minou65/NMEA2000-SensorBoard/NMEA-Sensorboard.brd

## EAGLE design NMEA-Sensorboard.brd (2026-08-22)

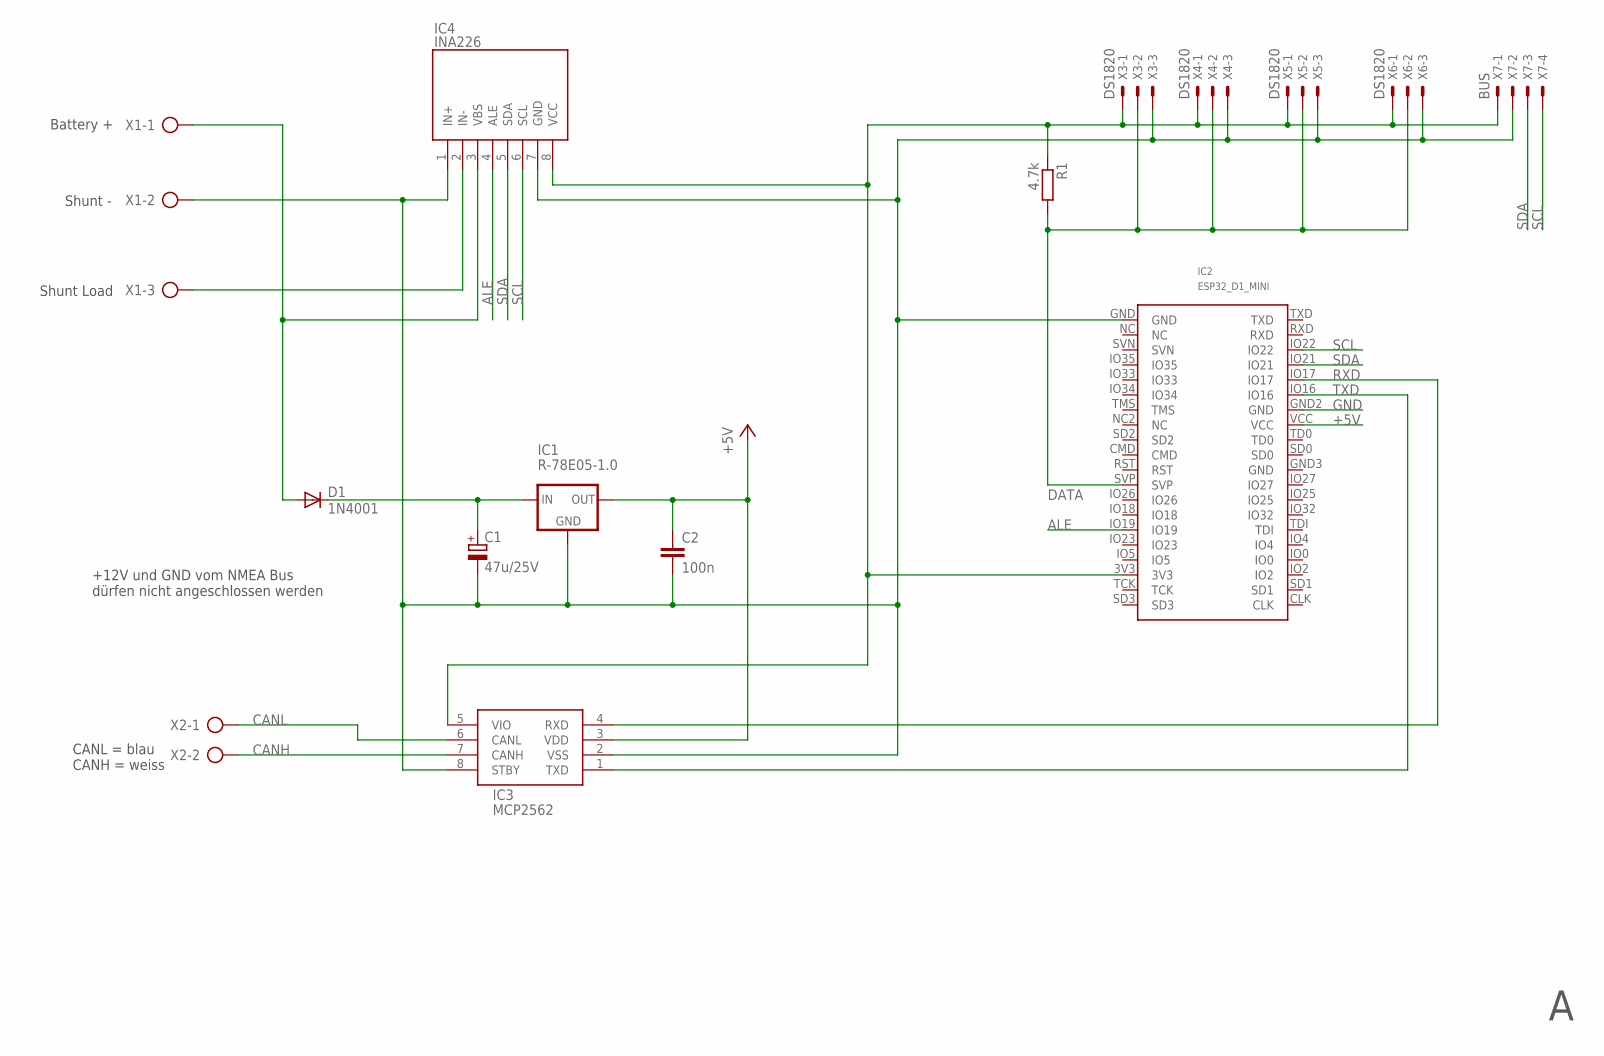
[picture p4: schematic NMEA-Sensorboard.sch]

Parts:
C1: 47u/25V; E2-5
C2: 100n; C050-024X044
D1: 1N4001; SOD80
IC1: R-78E05-1.0; R-78E-XX1.0
IC2: ESP32_D1_MINI
IC3: MCP2562; SO-8
IC4: INA226
R1: 4.7k; R0805
X1: AK500/3
X2: AK500/2
X3, X4, X5, X6: DS1820; 22-23-2031
X7: BUS; 22-23-2041

Connections:
12V: D1.A, IC4.3 (VBS), X1.1
+3V3: IC2.3V3, IC3.5 (VIO), IC4.8 (VCC), R1.1, X3.1, X4.1, X5.1, X6.1, X7.1
+5V: C2.1, IC1.OUT, IC2.VCC, IC3.3 (VDD)
ALE: IC2.IO19, IC4.4 (ALE)
CANH: IC3.7 (CANH), X2.2
CANL: IC3.6 (CANL), X2.1
DATA: IC2.SVP, R1.2, X3.2, X4.2, X5.2, X6.2
GND: C1.-, C2.2, IC1.GND, IC2.GND, IC2.GND2 (GND), IC3.2 (VSS), IC3.8 (STBY), IC4.1 (IN+), IC4.7 (GND), X1.2, X3.3, X4.3, X5.3, X6.3, X7.2
LOAD: IC4.2 (IN-), X1.3
unnamed: C1.+, D1.C, IC1.IN
RXD: IC2.IO17, IC3.4 (RXD)
SCL: IC2.IO22, IC4.6 (SCL), X7.4
SDA: IC2.IO21, IC4.5 (SDA), X7.3
TXD: IC2.IO16, IC3.1 (TXD)

Notes on the sheet:
CANL = blau CANH = weiss
Shunt -
Shunt Load
Battery +
+12V und GND vom NMEA Bus dürfen nicht angeschlossen werden

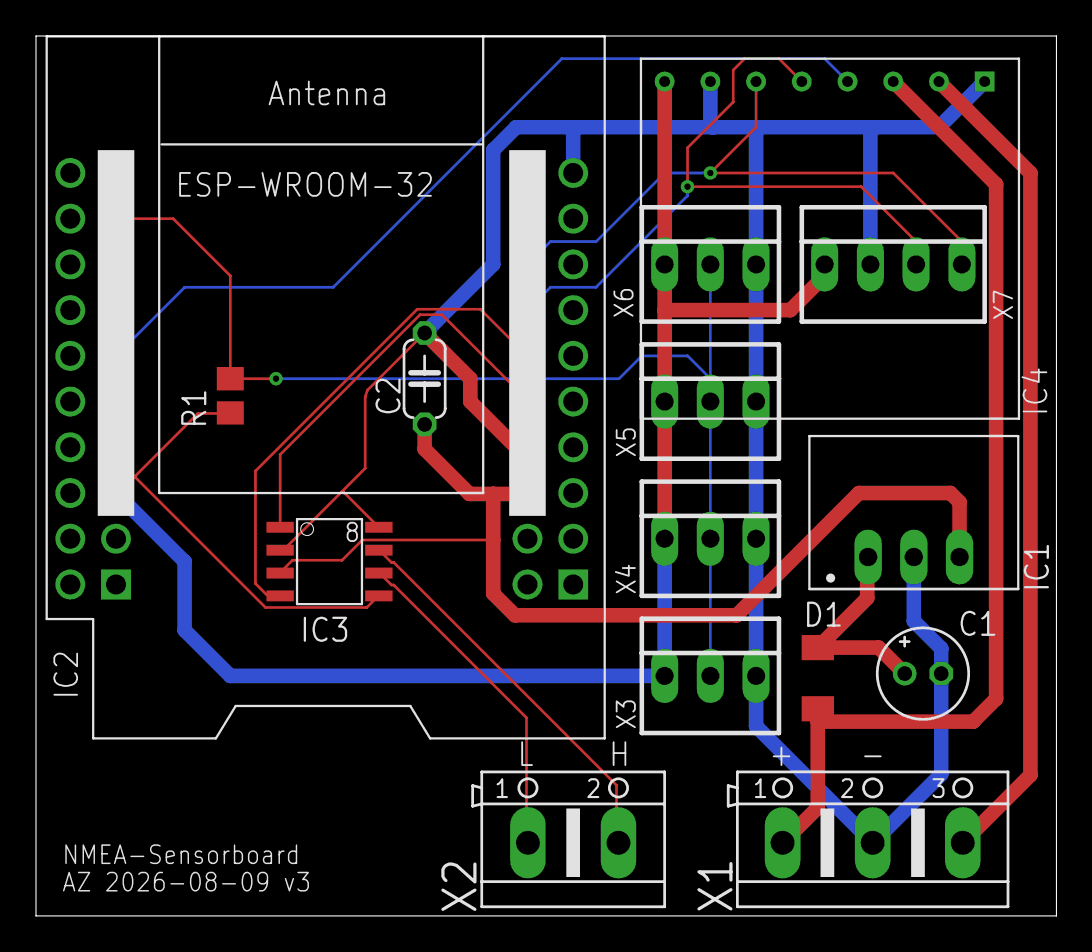
[picture p5: board NMEA-Sensorboard.brd from above]

Board: 2 copper layers, 56.7 x 48.9 mm, 15 parts (0 on the bottom side), 14 nets.
