minou65/NMEA2000-SensorBoard/(commit log)

2026-06-10 Add initial files for NMEA2000 Sensorboard project
    - Added schematic image (NMEA2000-Sensorboard.png)
    - Created part list (Partlist) detailing components used
    - Added README.md with project overview, supported projects, connector details, supply information, safety notes, and component selection by variant
    [NMEA-Sensorboard.brd, NMEA-Sensorboard.sch]
2026-06-22 Add ESP32 D1 Mini pinout reference to README
2026-06-22 Update GPIO pin assignments for DS1820 sensor in README
2026-06-24 Sensor oun changed
    [NMEA-Sensorboard.brd, NMEA-Sensorboard.sch]
2026-07-06 Update resistor value for R1
2026-08-22 refactor: overhaul schematic and PCB layout to fix multiple issues
    [NMEA-Sensorboard.sch]
2026-08-22 docs: add warning for DS1820 DATA line connection on Sensorboard v3
